EIT-team/NeuroADC/README.md

# NeuroADC
Open Source data acquisition system for biopotential recording and Fast Neural EIT, originally developed by Dr. Enrico Ravagli in 2026.
Contributions are welcome under GPL-3.0 license.
