EIT-team/NeuroADC/Schematics/README.md

# Schematics
- This subfolder contains design files for the three Printed Circuit Boards which make up the NeuroADC device. Board names are based on their physical location when assembled (top/mid/bottom)
- Boards have been designed using Cad software EAGLE. With EAGLE now being decommissioned in June 2026, board files can be opened and edited in Autodesk Fusion.
