EIT-team/NeuroADC/Data_acquisition_scripts/README.md

# Data acquisition scripts
These are example scripts for collecting data from the __NeuroADC__ device using Python and converting raw data to Matlab format.
- Script "**readout.py**" connects to the device and records data. Duration of recording and output file name can be edited in the script. Pay attention to using the serial number of your Mimas FPGA board for opening the connection.
- Script "**data_conversion.m**" reads the raw binary data file generated by the previous scripts and converts its to 32-channel format plus 8 separate trigger signals. Output is stored in a .mat file.

The scripts below are not needed for normal device operation.

- Script "**compute_CRC_lookup.m**" generates a lookup table used by data_conversion.m for CRC verification. It does not need to be run if its output "crctable.mat" is already present in the same folder.
- Script "**clean_chip.py**" resets the USB chip embedded in the FPGA board to its standard operating mode. It is useful if the readout script gets stuck for any reason (such as operating the device with the powerbank off or without pressing the start button). Run this script and then run readout.py again normally.
