EIT-team/NeuroADC/Schematics/EIT_Recorder_Mid/EIT_Recorder.brd

## EAGLE design Schematics/EIT_Recorder_Mid/EIT_Recorder.brd (2026-06-01)

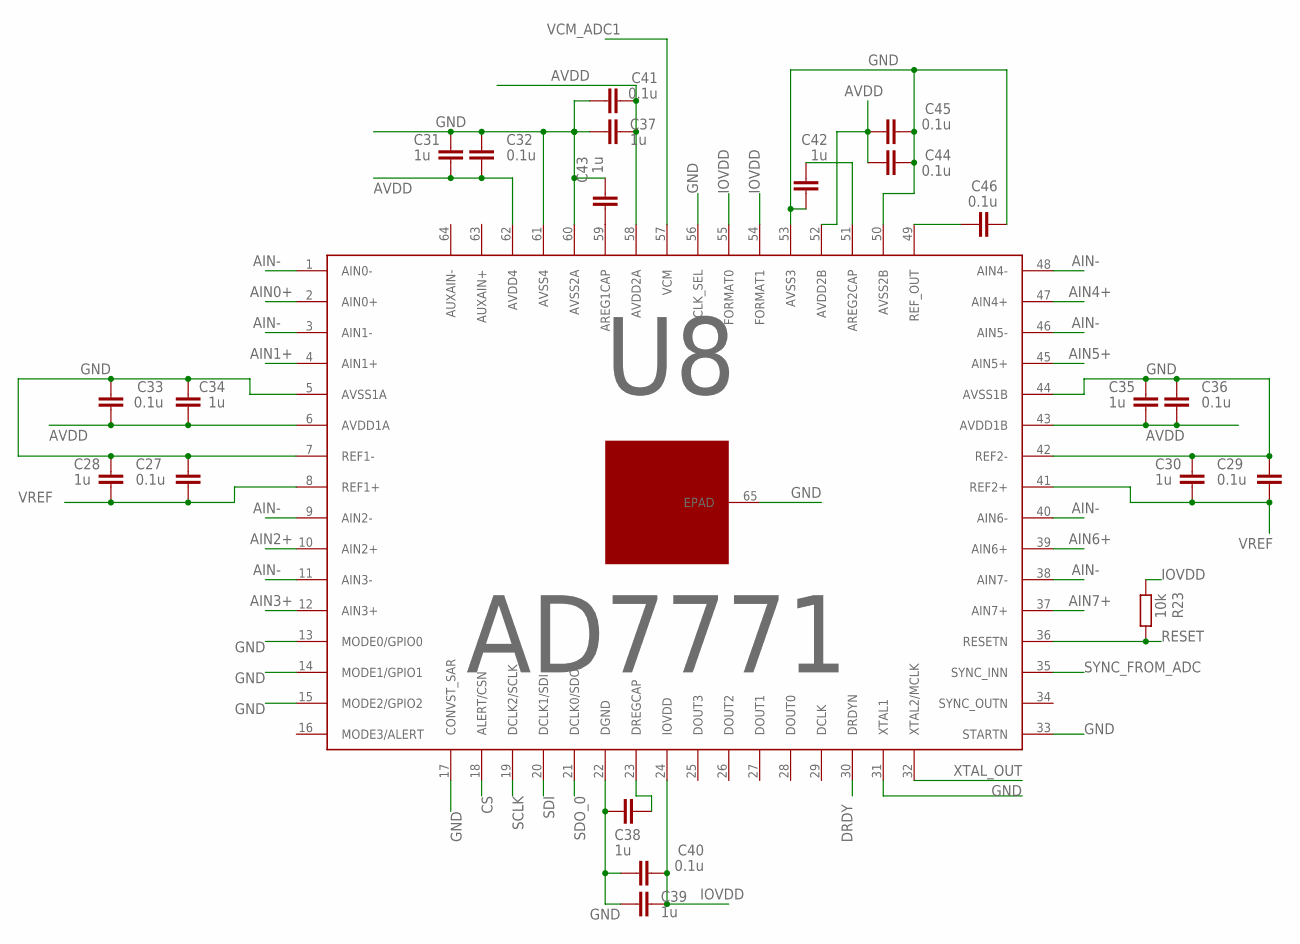
[picture p1: schematic EIT_Recorder.sch, sheet 1, ADC_1]

Parts:
C27, C29, C32, C33, C36, C40, C41, C44, C45, C46: 0.1u; C0402
C28, C30, C31, C34, C35, C37, C38, C39, C42, C43: 1u; C0402
R23: 10k; R0603
U8: AD7771; LFCSP64_CUSTOM

Connections:
AIN0+: U8.2 (AIN0+); also elsewhere on the board
AIN1+: U8.4 (AIN1+); also elsewhere on the board
AIN2+: U8.10 (AIN2+); also elsewhere on the board
AIN3+: U8.12 (AIN3+); also elsewhere on the board
AIN4+: U8.47 (AIN4+); also elsewhere on the board
AIN5+: U8.45 (AIN5+); also elsewhere on the board
AIN6+: U8.39 (AIN6+); also elsewhere on the board
AIN7+: U8.37 (AIN7+); also elsewhere on the board
AIN-: U8.1 (AIN0-), U8.3 (AIN1-), U8.9 (AIN2-), U8.11 (AIN3-), U8.38 (AIN7-), U8.40 (AIN6-), U8.46 (AIN5-), U8.48 (AIN4-); also elsewhere on the board
AVDD: C31.1, C32.1, C33.1, C34.1, C35.1, C36.1, C37.1, C41.1, C44.2, C45.2, U8.6 (AVDD1A), U8.43 (AVDD1B), U8.52 (AVDD2B), U8.58 (AVDD2A), U8.62 (AVDD4); also elsewhere on the board
CS: U8.18 (ALERT/CSN); also elsewhere on the board
DRDY: U8.30 (DRDYN); also elsewhere on the board
GND: C27.2, C28.2, C29.2, C30.2, C31.2, C32.2, C33.2, C34.2, C35.2, C36.2, C37.2, C38.1, C39.2, C40.2, C41.2, C42.2, C43.1, C44.1, C45.1, C46.1, U8.5 (AVSS1A), U8.7 (REF1-), U8.13 (MODE0/GPIO0), U8.14 (MODE1/GPIO1), U8.15 (MODE2/GPIO2), U8.17 (CONVST_SAR), U8.22 (DGND), U8.31 (XTAL1), U8.33 (STARTN), U8.42 (REF2-), U8.44 (AVSS1B), U8.50 (AVSS2B), U8.53 (AVSS3), U8.56 (CLK_SEL), U8.60 (AVSS2A), U8.61 (AVSS4), U8.65 (EPAD); also elsewhere on the board
IOVDD: C39.1, C40.1, R23.2, U8.24 (IOVDD), U8.54 (FORMAT1), U8.55 (FORMAT0); also elsewhere on the board
unnamed: C43.2, U8.59 (AREG1CAP)
unnamed: C38.2, U8.23 (DREGCAP)
unnamed: C46.2, U8.49 (REF_OUT)
unnamed: C42.1, U8.51 (AREG2CAP)
RESET: R23.1, U8.36 (RESETN); also elsewhere on the board
SCLK: U8.19 (DCLK2/SCLK); also elsewhere on the board
SDI: U8.20 (DCLK1/SDI); also elsewhere on the board
SDO_0: U8.21 (DCLK0/SDO); also elsewhere on the board
SYNC_FROM_ADC: U8.35 (SYNC_INN); also elsewhere on the board
VCM_ADC1: U8.57 (VCM); also elsewhere on the board
VREF: C27.1, C28.1, C29.1, C30.1, U8.8 (REF1+), U8.41 (REF2+); also elsewhere on the board
XTAL_OUT: U8.32 (XTAL2/MCLK); also elsewhere on the board

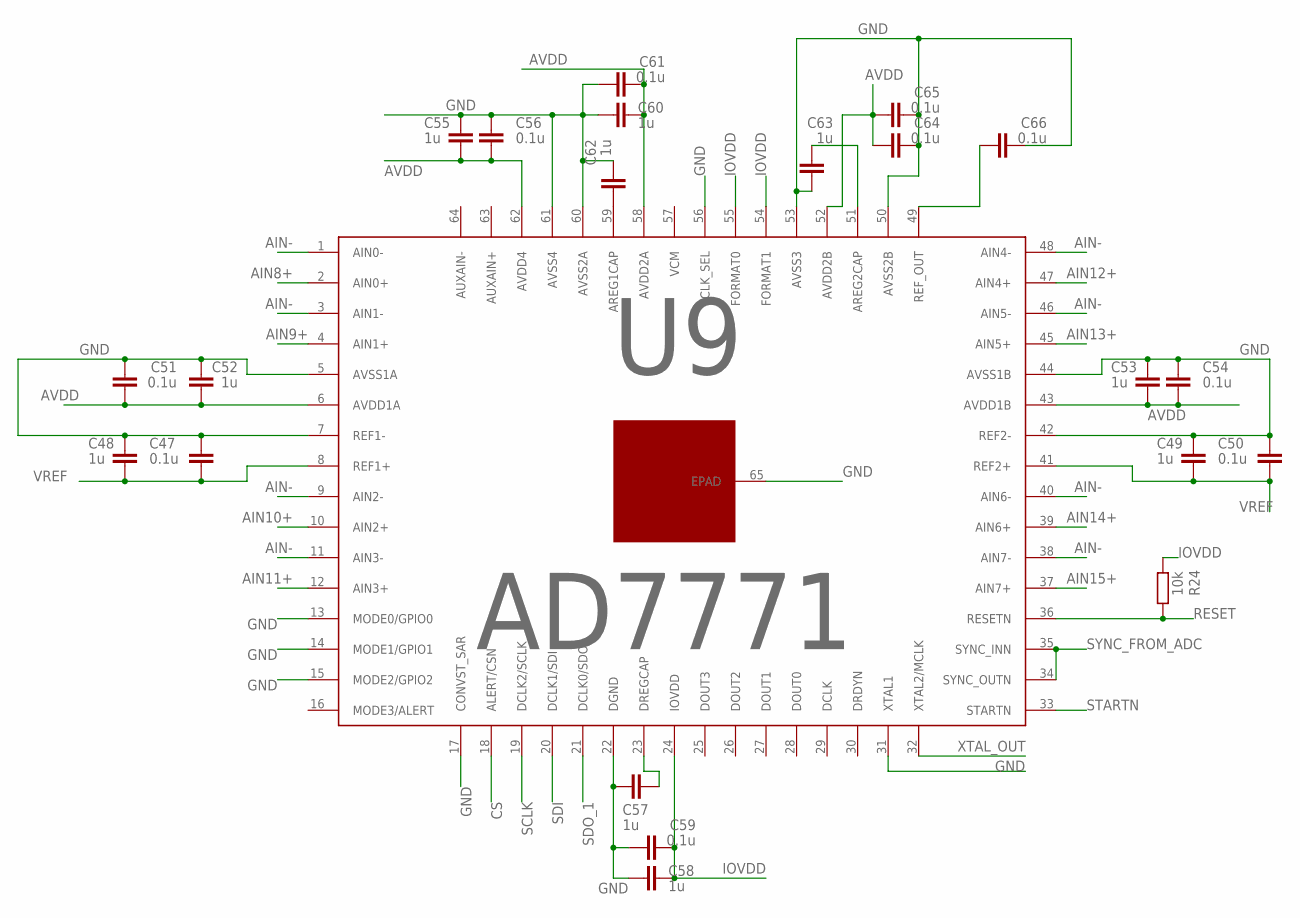
[picture p2: schematic EIT_Recorder.sch, sheet 2, ADC_2]

Parts:
C47, C50, C51, C54, C56, C59, C61, C64, C65, C66: 0.1u; C0402
C48, C49, C52, C53, C55, C57, C58, C60, C62, C63: 1u; C0402
R24: 10k; R0603
U9: AD7771; LFCSP64_CUSTOM

Connections:
AIN8+: U9.2 (AIN0+); also elsewhere on the board
AIN9+: U9.4 (AIN1+); also elsewhere on the board
AIN10+: U9.10 (AIN2+); also elsewhere on the board
AIN11+: U9.12 (AIN3+); also elsewhere on the board
AIN12+: U9.47 (AIN4+); also elsewhere on the board
AIN13+: U9.45 (AIN5+); also elsewhere on the board
AIN14+: U9.39 (AIN6+); also elsewhere on the board
AIN15+: U9.37 (AIN7+); also elsewhere on the board
AIN-: U9.1 (AIN0-), U9.3 (AIN1-), U9.9 (AIN2-), U9.11 (AIN3-), U9.38 (AIN7-), U9.40 (AIN6-), U9.46 (AIN5-), U9.48 (AIN4-); also elsewhere on the board
AVDD: C51.1, C52.1, C53.1, C54.1, C55.1, C56.1, C60.1, C61.1, C64.2, C65.2, U9.6 (AVDD1A), U9.43 (AVDD1B), U9.52 (AVDD2B), U9.58 (AVDD2A), U9.62 (AVDD4); also elsewhere on the board
CS: U9.18 (ALERT/CSN); also elsewhere on the board
GND: C47.2, C48.2, C49.2, C50.2, C51.2, C52.2, C53.2, C54.2, C55.2, C56.2, C57.1, C58.2, C59.2, C60.2, C61.2, C62.1, C63.2, C64.1, C65.1, C66.1, U9.5 (AVSS1A), U9.7 (REF1-), U9.13 (MODE0/GPIO0), U9.14 (MODE1/GPIO1), U9.15 (MODE2/GPIO2), U9.17 (CONVST_SAR), U9.22 (DGND), U9.31 (XTAL1), U9.42 (REF2-), U9.44 (AVSS1B), U9.50 (AVSS2B), U9.53 (AVSS3), U9.56 (CLK_SEL), U9.60 (AVSS2A), U9.61 (AVSS4), U9.65 (EPAD); also elsewhere on the board
IOVDD: C58.1, C59.1, R24.2, U9.24 (IOVDD), U9.54 (FORMAT1), U9.55 (FORMAT0); also elsewhere on the board
unnamed: C57.2, U9.23 (DREGCAP)
unnamed: C62.2, U9.59 (AREG1CAP)
unnamed: C63.1, U9.51 (AREG2CAP)
unnamed: C66.2, U9.49 (REF_OUT)
RESET: R24.1, U9.36 (RESETN); also elsewhere on the board
SCLK: U9.19 (DCLK2/SCLK); also elsewhere on the board
SDI: U9.20 (DCLK1/SDI); also elsewhere on the board
SDO_1: U9.21 (DCLK0/SDO); also elsewhere on the board
STARTN: U9.33 (STARTN); also elsewhere on the board
SYNC_FROM_ADC: U9.34 (SYNC_OUTN), U9.35 (SYNC_INN); also elsewhere on the board
VREF: C47.1, C48.1, C49.1, C50.1, U9.8 (REF1+), U9.41 (REF2+); also elsewhere on the board
XTAL_OUT: U9.32 (XTAL2/MCLK); also elsewhere on the board

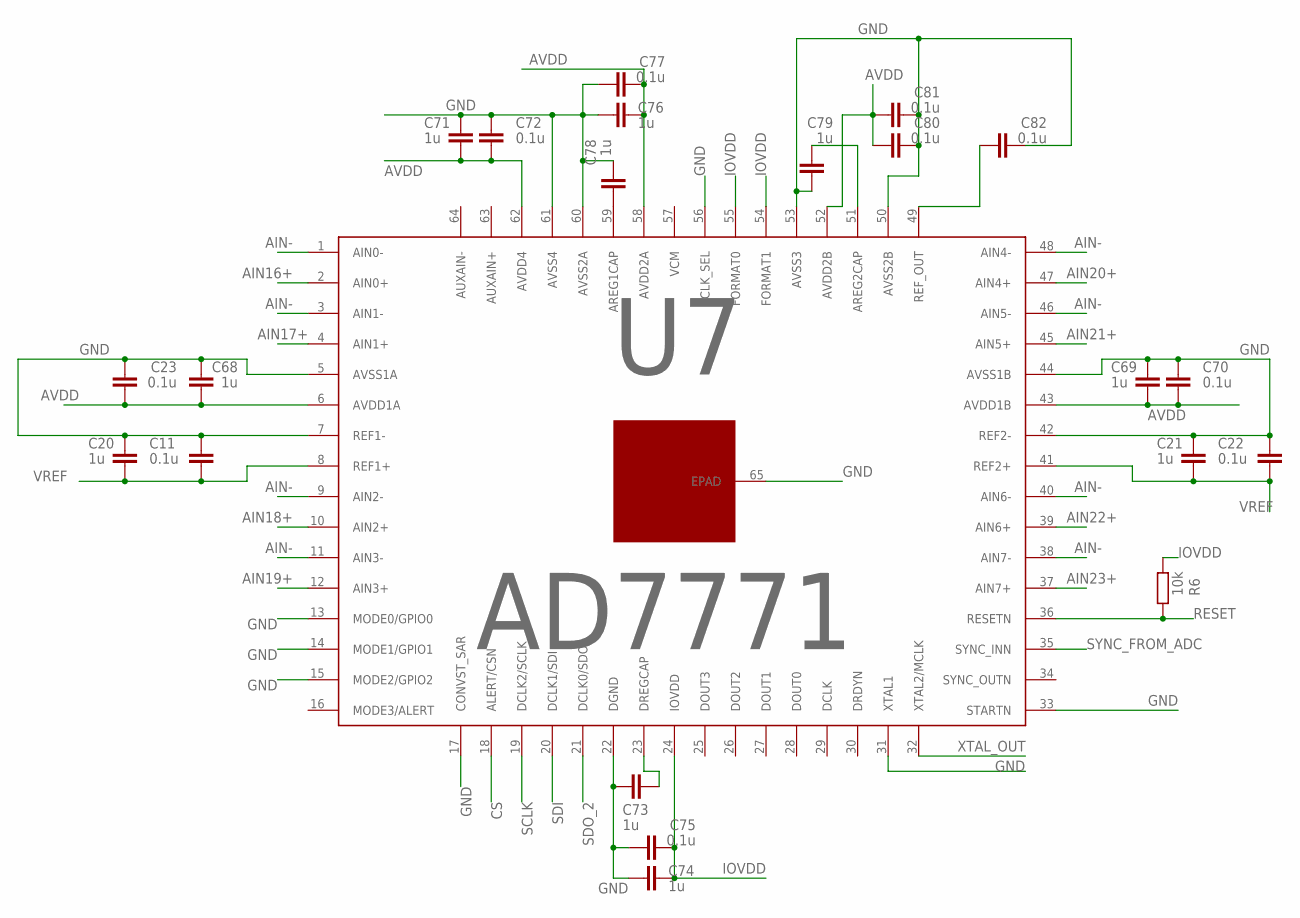
[picture p3: schematic EIT_Recorder.sch, sheet 3, ADC_3]

Parts:
C11, C22, C23, C70, C72, C75, C77, C80, C81, C82: 0.1u; C0402
C20, C21, C68, C69, C71, C73, C74, C76, C78, C79: 1u; C0402
R6: 10k; R0603
U7: AD7771; LFCSP64_CUSTOM

Connections:
AIN16+: U7.2 (AIN0+); also elsewhere on the board
AIN17+: U7.4 (AIN1+); also elsewhere on the board
AIN18+: U7.10 (AIN2+); also elsewhere on the board
AIN19+: U7.12 (AIN3+); also elsewhere on the board
AIN20+: U7.47 (AIN4+); also elsewhere on the board
AIN21+: U7.45 (AIN5+); also elsewhere on the board
AIN22+: U7.39 (AIN6+); also elsewhere on the board
AIN23+: U7.37 (AIN7+); also elsewhere on the board
AIN-: U7.1 (AIN0-), U7.3 (AIN1-), U7.9 (AIN2-), U7.11 (AIN3-), U7.38 (AIN7-), U7.40 (AIN6-), U7.46 (AIN5-), U7.48 (AIN4-); also elsewhere on the board
AVDD: C23.1, C68.1, C69.1, C70.1, C71.1, C72.1, C76.1, C77.1, C80.2, C81.2, U7.6 (AVDD1A), U7.43 (AVDD1B), U7.52 (AVDD2B), U7.58 (AVDD2A), U7.62 (AVDD4); also elsewhere on the board
CS: U7.18 (ALERT/CSN); also elsewhere on the board
GND: C11.2, C20.2, C21.2, C22.2, C23.2, C68.2, C69.2, C70.2, C71.2, C72.2, C73.1, C74.2, C75.2, C76.2, C77.2, C78.1, C79.2, C80.1, C81.1, C82.1, U7.5 (AVSS1A), U7.7 (REF1-), U7.13 (MODE0/GPIO0), U7.14 (MODE1/GPIO1), U7.15 (MODE2/GPIO2), U7.17 (CONVST_SAR), U7.22 (DGND), U7.31 (XTAL1), U7.33 (STARTN), U7.42 (REF2-), U7.44 (AVSS1B), U7.50 (AVSS2B), U7.53 (AVSS3), U7.56 (CLK_SEL), U7.60 (AVSS2A), U7.61 (AVSS4), U7.65 (EPAD); also elsewhere on the board
IOVDD: C74.1, C75.1, R6.2, U7.24 (IOVDD), U7.54 (FORMAT1), U7.55 (FORMAT0); also elsewhere on the board
unnamed: C73.2, U7.23 (DREGCAP)
unnamed: C78.2, U7.59 (AREG1CAP)
unnamed: C79.1, U7.51 (AREG2CAP)
unnamed: C82.2, U7.49 (REF_OUT)
RESET: R6.1, U7.36 (RESETN); also elsewhere on the board
SCLK: U7.19 (DCLK2/SCLK); also elsewhere on the board
SDI: U7.20 (DCLK1/SDI); also elsewhere on the board
SDO_2: U7.21 (DCLK0/SDO); also elsewhere on the board
SYNC_FROM_ADC: U7.35 (SYNC_INN); also elsewhere on the board
VREF: C11.1, C20.1, C21.1, C22.1, U7.8 (REF1+), U7.41 (REF2+); also elsewhere on the board
XTAL_OUT: U7.32 (XTAL2/MCLK); also elsewhere on the board

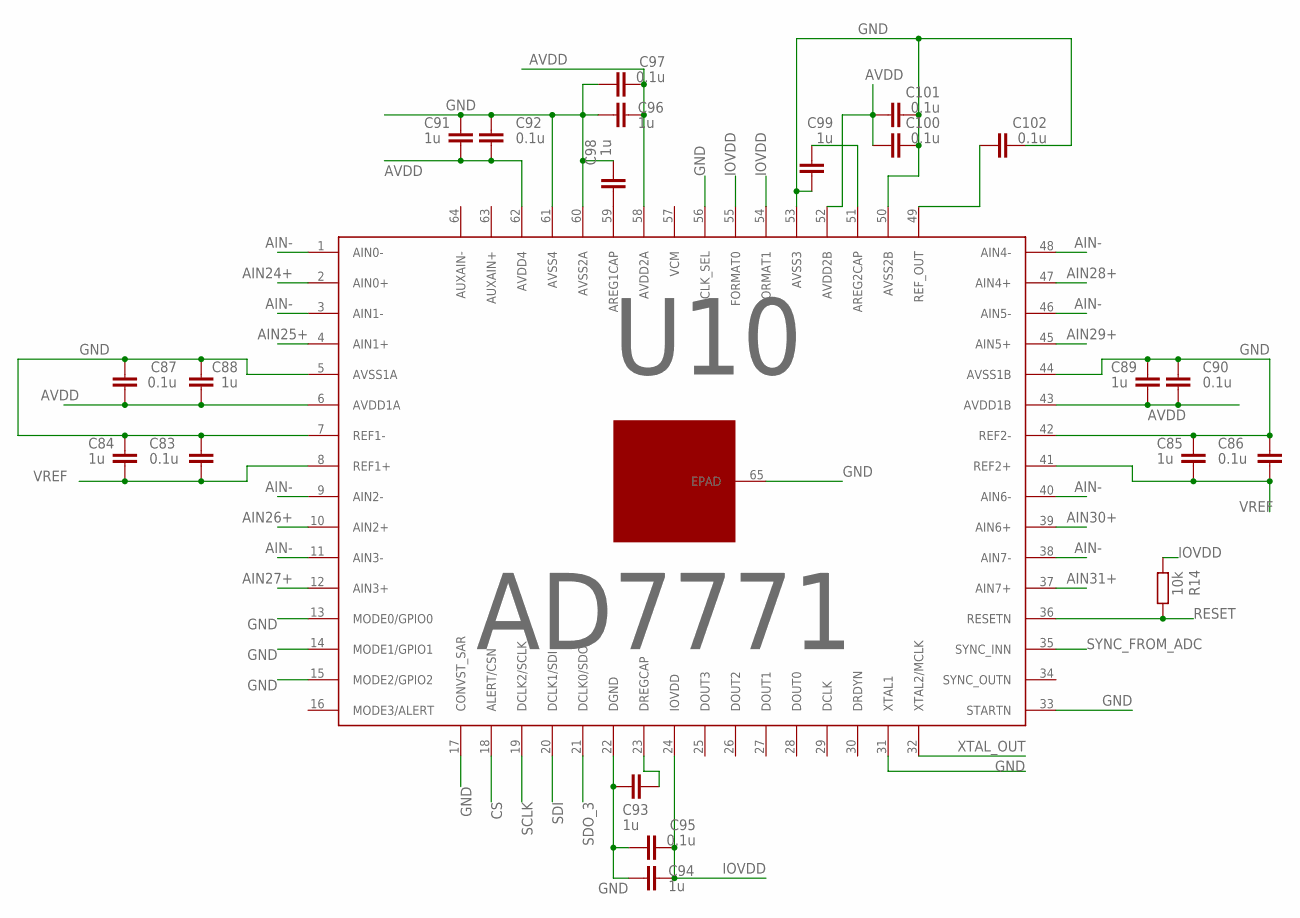
[picture p4: schematic EIT_Recorder.sch, sheet 4, ADC_4]

Parts:
C83, C86, C87, C90, C92, C95, C97, C100, C101, C102: 0.1u; C0402
C84, C85, C88, C89, C91, C93, C94, C96, C98, C99: 1u; C0402
R14: 10k; R0603
U10: AD7771; LFCSP64_CUSTOM

Connections:
AIN24+: U10.2 (AIN0+); also elsewhere on the board
AIN25+: U10.4 (AIN1+); also elsewhere on the board
AIN26+: U10.10 (AIN2+); also elsewhere on the board
AIN27+: U10.12 (AIN3+); also elsewhere on the board
AIN28+: U10.47 (AIN4+); also elsewhere on the board
AIN29+: U10.45 (AIN5+); also elsewhere on the board
AIN30+: U10.39 (AIN6+); also elsewhere on the board
AIN31+: U10.37 (AIN7+); also elsewhere on the board
AIN-: U10.1 (AIN0-), U10.3 (AIN1-), U10.9 (AIN2-), U10.11 (AIN3-), U10.38 (AIN7-), U10.40 (AIN6-), U10.46 (AIN5-), U10.48 (AIN4-); also elsewhere on the board
AVDD: C87.1, C88.1, C89.1, C90.1, C91.1, C92.1, C96.1, C97.1, C100.2, C101.2, U10.6 (AVDD1A), U10.43 (AVDD1B), U10.52 (AVDD2B), U10.58 (AVDD2A), U10.62 (AVDD4); also elsewhere on the board
CS: U10.18 (ALERT/CSN); also elsewhere on the board
GND: C83.2, C84.2, C85.2, C86.2, C87.2, C88.2, C89.2, C90.2, C91.2, C92.2, C93.1, C94.2, C95.2, C96.2, C97.2, C98.1, C99.2, C100.1, C101.1, C102.1, U10.5 (AVSS1A), U10.7 (REF1-), U10.13 (MODE0/GPIO0), U10.14 (MODE1/GPIO1), U10.15 (MODE2/GPIO2), U10.17 (CONVST_SAR), U10.22 (DGND), U10.31 (XTAL1), U10.33 (STARTN), U10.42 (REF2-), U10.44 (AVSS1B), U10.50 (AVSS2B), U10.53 (AVSS3), U10.56 (CLK_SEL), U10.60 (AVSS2A), U10.61 (AVSS4), U10.65 (EPAD); also elsewhere on the board
IOVDD: C94.1, C95.1, R14.2, U10.24 (IOVDD), U10.54 (FORMAT1), U10.55 (FORMAT0); also elsewhere on the board
unnamed: C93.2, U10.23 (DREGCAP)
unnamed: C98.2, U10.59 (AREG1CAP)
unnamed: C99.1, U10.51 (AREG2CAP)
unnamed: C102.2, U10.49 (REF_OUT)
RESET: R14.1, U10.36 (RESETN); also elsewhere on the board
SCLK: U10.19 (DCLK2/SCLK); also elsewhere on the board
SDI: U10.20 (DCLK1/SDI); also elsewhere on the board
SDO_3: U10.21 (DCLK0/SDO); also elsewhere on the board
SYNC_FROM_ADC: U10.35 (SYNC_INN); also elsewhere on the board
VREF: C83.1, C84.1, C85.1, C86.1, U10.8 (REF1+), U10.41 (REF2+); also elsewhere on the board
XTAL_OUT: U10.32 (XTAL2/MCLK); also elsewhere on the board

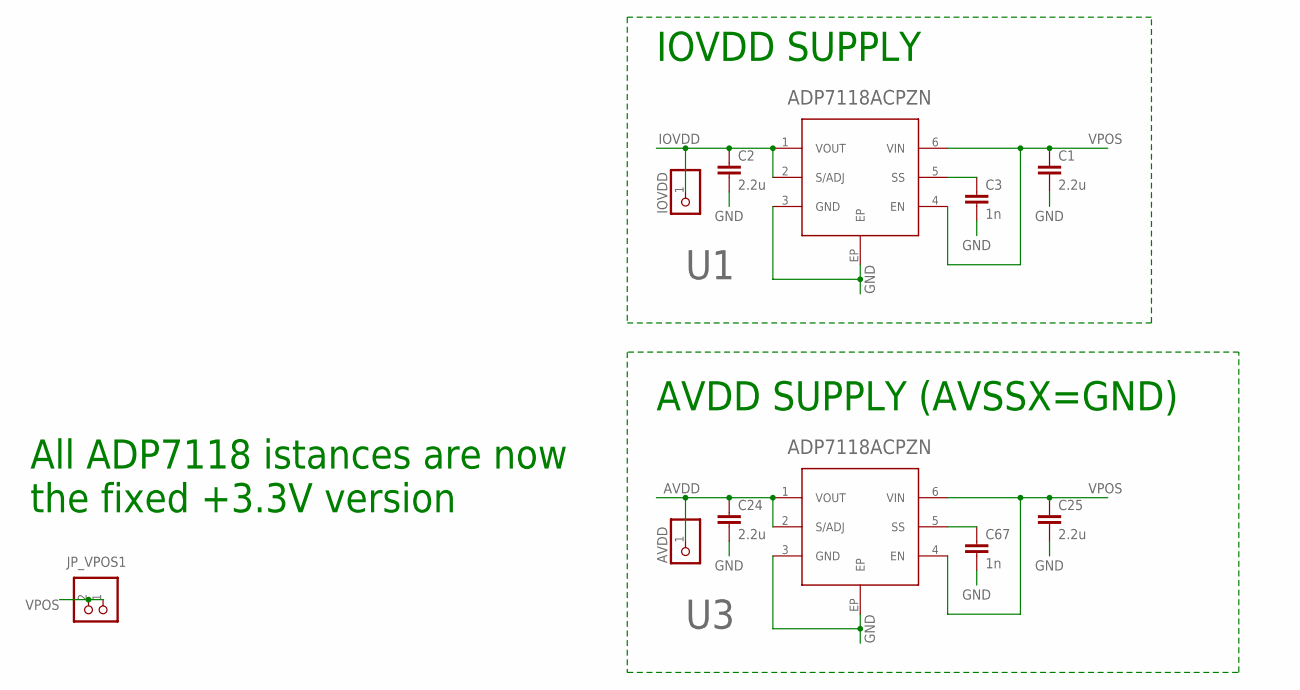
[picture p5: schematic EIT_Recorder.sch, sheet 5, POWER_MANAGEMENT_1]

Parts:
AVDD: PINHD-1X1; 1X01
C1, C2, C24, C25: 2.2u; C0603
C3, C67: 1n; C0402
IOVDD: PINHD-1X1; 1X01
JP_VPOS1: PINHD-1X2; 1X02
U1, U3: ADP7118ACPZN; LFCSP6_CUSTOM

Connections:
AVDD: AVDD.1, C24.1, U3.1 (VOUT), U3.2 (S/ADJ); also elsewhere on the board
GND: C1.2, C2.2, C3.2, C24.2, C25.2, C67.2, U1.3 (GND), U1.EP, U3.3 (GND), U3.EP; also elsewhere on the board
IOVDD: C2.1, IOVDD.1, U1.1 (VOUT), U1.2 (S/ADJ); also elsewhere on the board
unnamed: C3.1, U1.5 (SS)
unnamed: C67.1, U3.5 (SS)
VPOS: C1.1, C25.1, JP_VPOS1.1, JP_VPOS1.2, U1.4 (EN), U1.6 (VIN), U3.4 (EN), U3.6 (VIN); also elsewhere on the board

Notes on the sheet:
IOVDD SUPPLY
AVDD SUPPLY (AVSSX=GND)
All ADP7118 istances are now the fixed +3.3V version

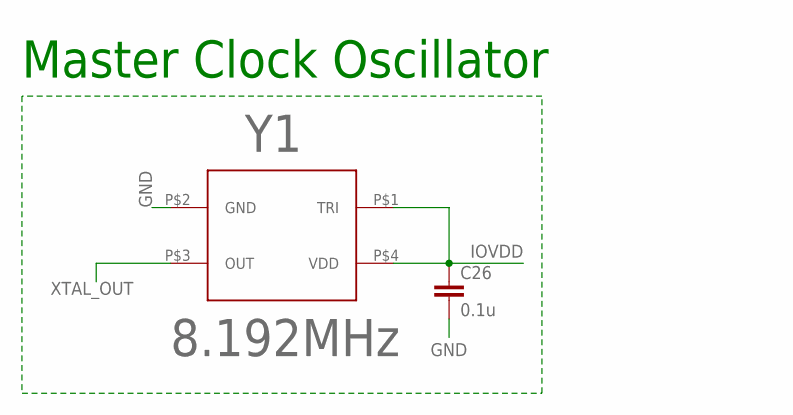
[picture p6: schematic EIT_Recorder.sch, sheet 6, POWER_MANAGEMENT_2]

Parts:
C26: 0.1u; C0402
Y1: 8.192MHz; ECS-2520MVLC

Connections:
GND: C26.2, Y1.P$2 (GND); also elsewhere on the board
IOVDD: C26.1, Y1.P$1 (TRI), Y1.P$4 (VDD); also elsewhere on the board
XTAL_OUT: Y1.P$3 (OUT); also elsewhere on the board

Notes on the sheet:
Master Clock Oscillator

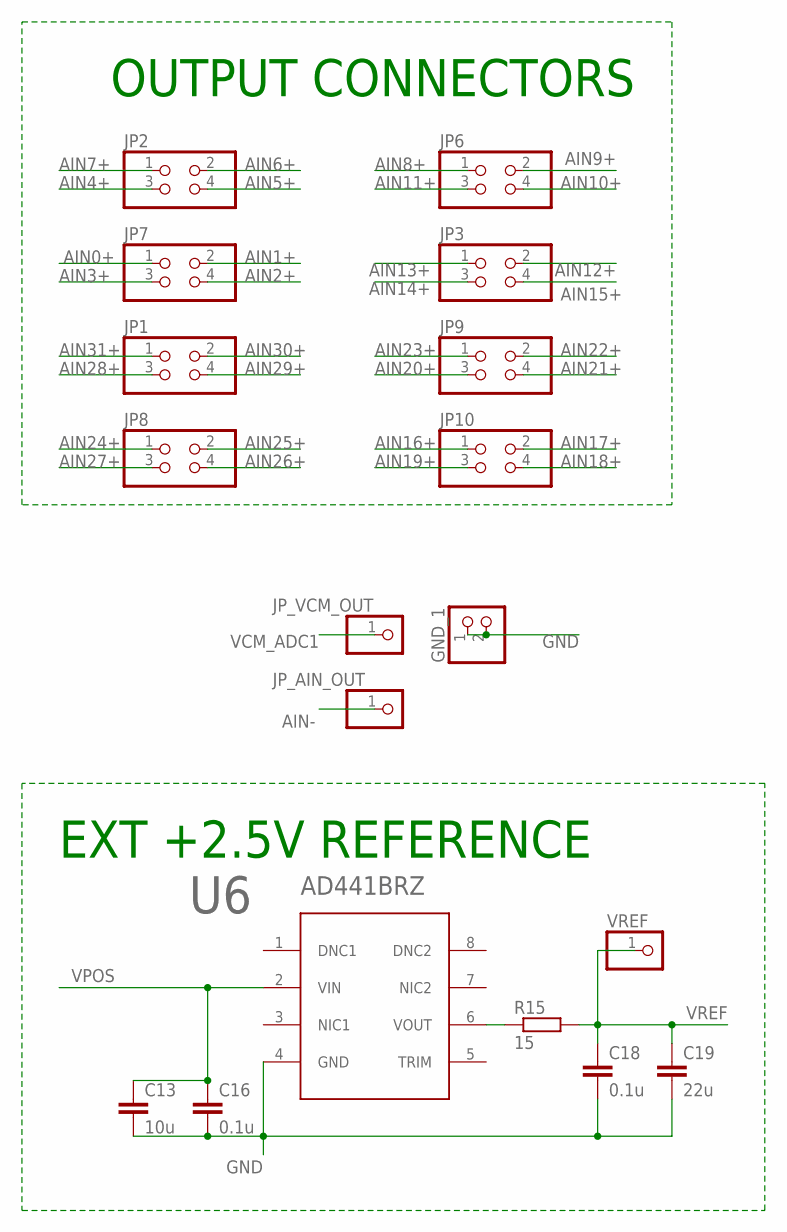
[picture p7: schematic EIT_Recorder.sch, sheet 7, BUFFERS_AND_VREF]

Parts:
C13: 10u; C0805
C16, C18: 0.1u; C0402
C19: 22u; C0805
GND_1: PINHD-1X2; 1X02
JP1, JP2, JP3, JP6, JP7, JP8, JP9, JP10: PINHD-2X2; 2X02
JP_AIN_OUT: PINHD-1X1; 1X01
JP_VCM_OUT: PINHD-1X1; 1X01
R15: 15; R0603
U6: AD441BRZ; SOIC8N_CUSTOM
VREF: PINHD-1X1; 1X01

Connections:
AIN0+: JP7.1; also elsewhere on the board
AIN1+: JP7.2; also elsewhere on the board
AIN2+: JP7.4; also elsewhere on the board
AIN3+: JP7.3; also elsewhere on the board
AIN4+: JP2.3; also elsewhere on the board
AIN5+: JP2.4; also elsewhere on the board
AIN6+: JP2.2; also elsewhere on the board
AIN7+: JP2.1; also elsewhere on the board
AIN8+: JP6.1; also elsewhere on the board
AIN9+: JP6.2; also elsewhere on the board
AIN10+: JP6.4; also elsewhere on the board
AIN11+: JP6.3; also elsewhere on the board
AIN12+: JP3.2; also elsewhere on the board
AIN13+: JP3.1; also elsewhere on the board
AIN14+: JP3.3; also elsewhere on the board
AIN15+: JP3.4; also elsewhere on the board
AIN16+: JP10.1; also elsewhere on the board
AIN17+: JP10.2; also elsewhere on the board
AIN18+: JP10.4; also elsewhere on the board
AIN19+: JP10.3; also elsewhere on the board
AIN20+: JP9.3; also elsewhere on the board
AIN21+: JP9.4; also elsewhere on the board
AIN22+: JP9.2; also elsewhere on the board
AIN23+: JP9.1; also elsewhere on the board
AIN24+: JP8.1; also elsewhere on the board
AIN25+: JP8.2; also elsewhere on the board
AIN26+: JP8.4; also elsewhere on the board
AIN27+: JP8.3; also elsewhere on the board
AIN28+: JP1.3; also elsewhere on the board
AIN29+: JP1.4; also elsewhere on the board
AIN30+: JP1.2; also elsewhere on the board
AIN31+: JP1.1; also elsewhere on the board
AIN-: JP_AIN_OUT.1; also elsewhere on the board
GND: C13.2, C16.2, C18.2, C19.2, GND_1.1, GND_1.2, U6.4 (GND); also elsewhere on the board
unnamed: R15.1, U6.6 (VOUT)
VCM_ADC1: JP_VCM_OUT.1; also elsewhere on the board
VPOS: C13.1, C16.1, U6.2 (VIN); also elsewhere on the board
VREF: C18.1, C19.1, R15.2, VREF.1; also elsewhere on the board

Notes on the sheet:
EXT +2.5V REFERENCE
OUTPUT CONNECTORS

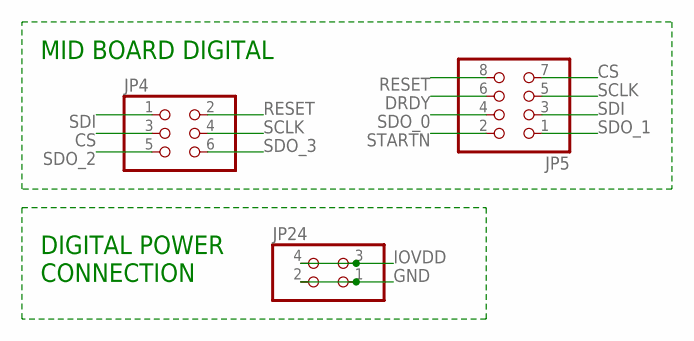
[picture p8: schematic EIT_Recorder.sch, sheet 8, DIGITAL]

Parts:
JP4: PINHD-2X3; 2X03
JP5: PINHD-2X4; 2X04
JP24: PINHD-2X2; 2X02

Connections:
CS: JP4.3, JP5.7; also elsewhere on the board
DRDY: JP5.6; also elsewhere on the board
GND: JP24.1, JP24.2; also elsewhere on the board
IOVDD: JP24.3, JP24.4; also elsewhere on the board
RESET: JP4.2, JP5.8; also elsewhere on the board
SCLK: JP4.4, JP5.5; also elsewhere on the board
SDI: JP4.1, JP5.3; also elsewhere on the board
SDO_0: JP5.4; also elsewhere on the board
SDO_1: JP5.1; also elsewhere on the board
SDO_2: JP4.5; also elsewhere on the board
SDO_3: JP4.6; also elsewhere on the board
STARTN: JP5.2; also elsewhere on the board

Notes on the sheet:
MID BOARD DIGITAL
DIGITAL POWER CONNECTION

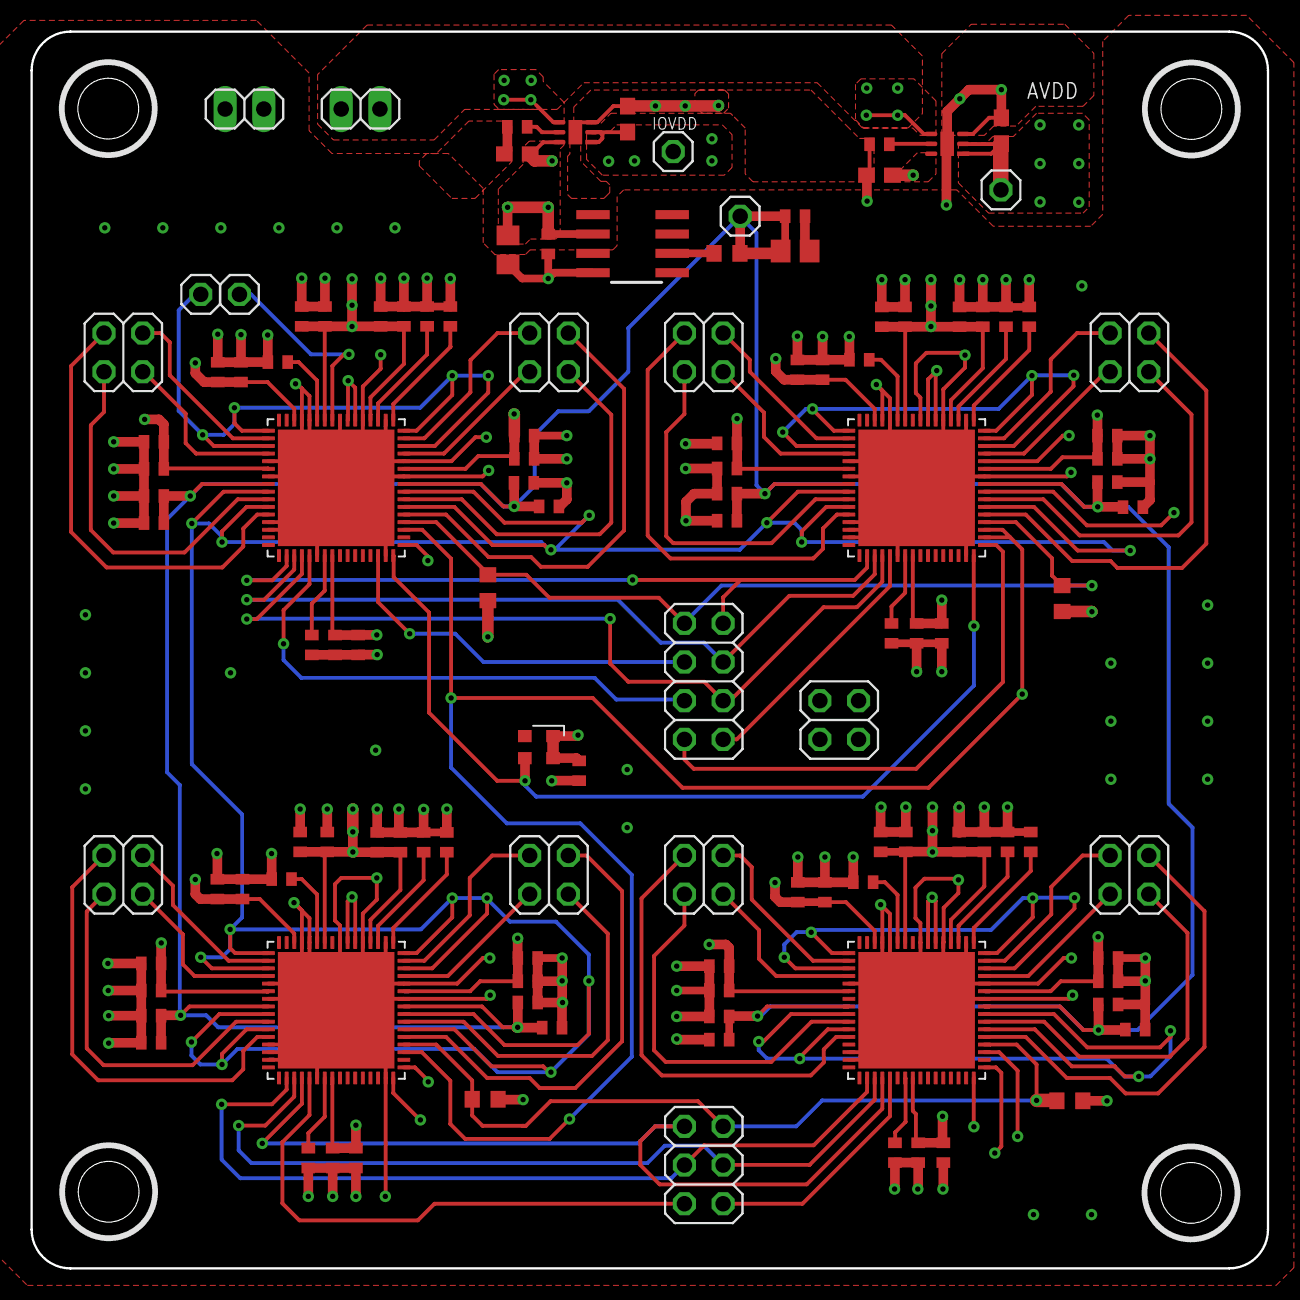
[picture p9: board Schematics/EIT_Recorder_Mid/EIT_Recorder.brd from above]

Board: 6 copper layers, 81.2 x 81.2 mm, 122 parts (0 on the bottom side), 70 nets.
