EIT-team/NeuroADC/Schematics/EIT_Recorder_Top/EIT_Recorder.brd

## EAGLE design Schematics/EIT_Recorder_Top/EIT_Recorder.brd (2026-06-01)

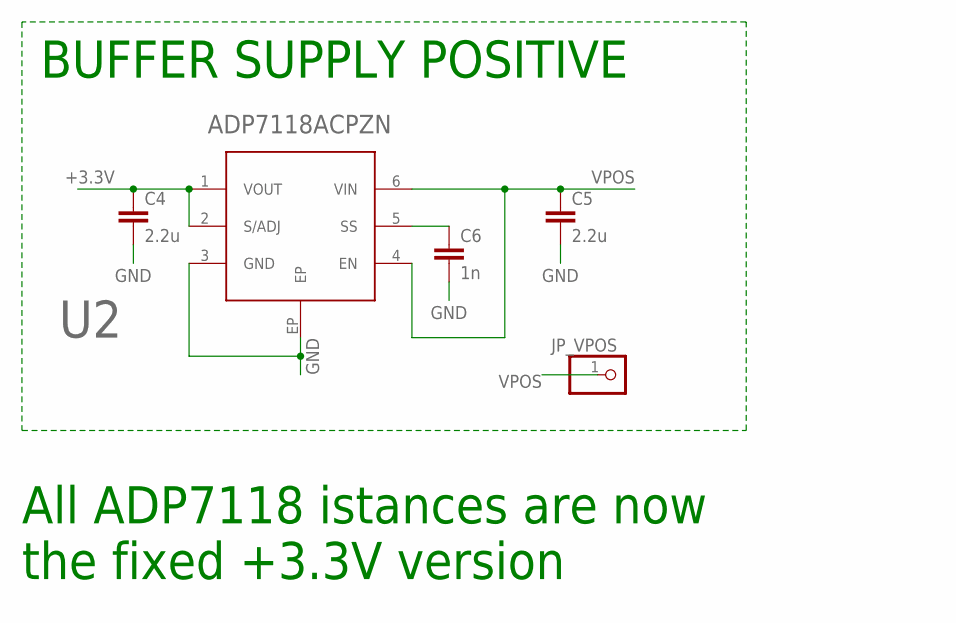
[picture p10: schematic EIT_Recorder.sch, sheet 1, POWER_MANAGEMENT_1]

Parts:
C4, C5: 2.2u; C0603
C6: 1n; C0402
JP_VPOS: PINHD-1X1; 1X01
U2: ADP7118ACPZN; LFCSP6_CUSTOM

Connections:
+3.3V: C4.1, U2.1 (VOUT), U2.2 (S/ADJ); also elsewhere on the board
GND: C4.2, C5.2, C6.2, U2.3 (GND), U2.EP; also elsewhere on the board
unnamed: C6.1, U2.5 (SS)
VPOS: C5.1, JP_VPOS.1, U2.4 (EN), U2.6 (VIN); also elsewhere on the board

Notes on the sheet:
BUFFER SUPPLY POSITIVE
All ADP7118 istances are now the fixed +3.3V version

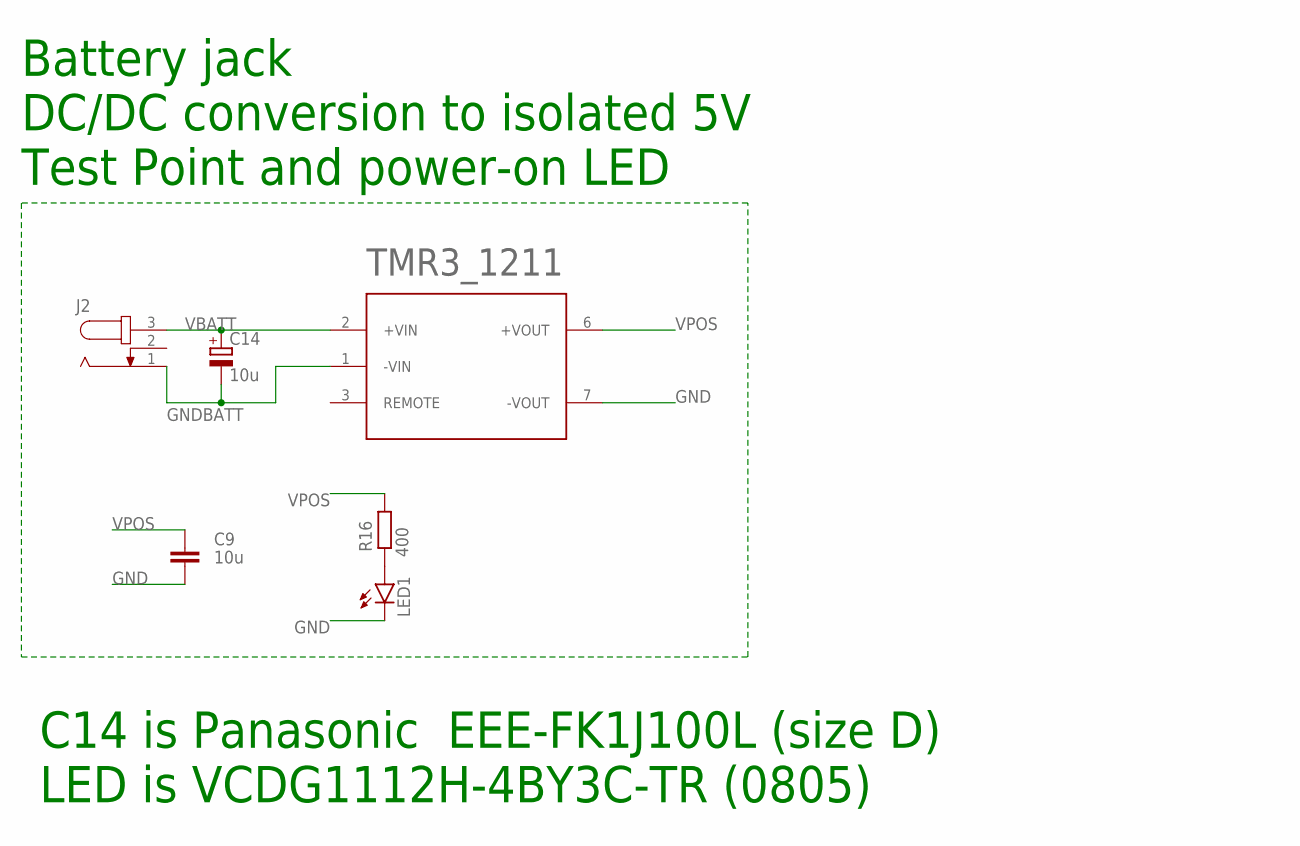
[picture p11: schematic EIT_Recorder.sch, sheet 2, POWER_MANAGEMENT_2]

Parts:
C9: 10u; C0805
C14: 10u; PANASONIC_D
J2: JACK-PLUG0; SPC4077
LED1: LEDCHIP-LED0805; CHIP-LED0805
R16: 400; R0805
TMR3_1211: TMR3_1211

Connections:
GND: C9.2, LED1.C, TMR3_1211.7 (-VOUT); also elsewhere on the board
GNDBATT: C14.-, J2.1, TMR3_1211.1 (-VIN)
unnamed: LED1.A, R16.1
VBATT: C14.+, J2.3, TMR3_1211.2 (+VIN)
VPOS: C9.1, R16.2, TMR3_1211.6 (+VOUT); also elsewhere on the board

Notes on the sheet:
C14 is Panasonic EEE-FK1J100L (size D) LED is VCDG1112H-4BY3C-TR (0805)
Battery jack DC/DC conversion to isolated 5V Test Point and power-on LED

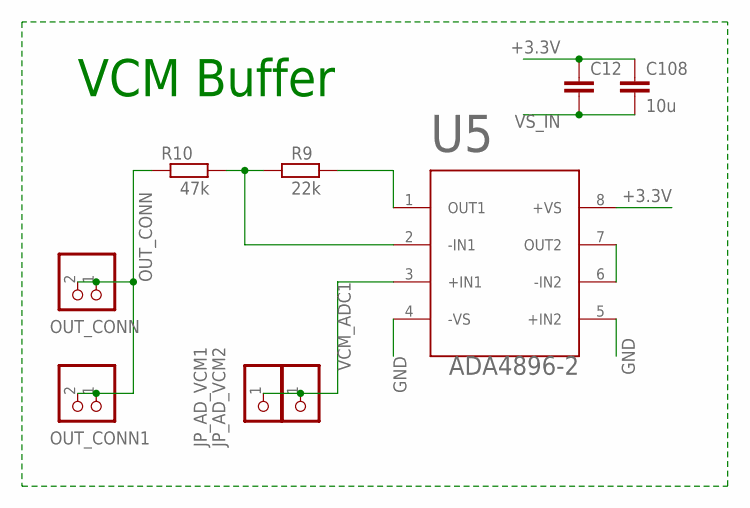
[picture p12: schematic EIT_Recorder.sch, sheet 3, BUFFERS_AND_VREF]

Parts:
C12: 0.1u; C0402
C108: 10u; C0805
JP_AD_VCM1, JP_AD_VCM2: PINHD-1X1; 1X01
OUT_CONN, OUT_CONN1: PINHD-1X2; 1X02
R9: 22k; R0603
R10: 47k; R0603
U5: ADA4896-2; MSOP8_CUSTOM

Connections:
+3.3V: C12.1, C108.1, U5.8 (+VS); also elsewhere on the board
GND: U5.4 (-VS), U5.5 (+IN2); also elsewhere on the board
unnamed: U5.6 (-IN2), U5.7 (OUT2)
unnamed: R9.2, U5.1 (OUT1)
unnamed: R9.1, R10.2, U5.2 (-IN1)
OUT_CONN: OUT_CONN.1, OUT_CONN.2, OUT_CONN1.1, OUT_CONN1.2, R10.1
VCM_ADC1: JP_AD_VCM1.1, JP_AD_VCM2.1, U5.3 (+IN1)
VS_IN: C12.2, C108.2

Notes on the sheet:
VCM Buffer

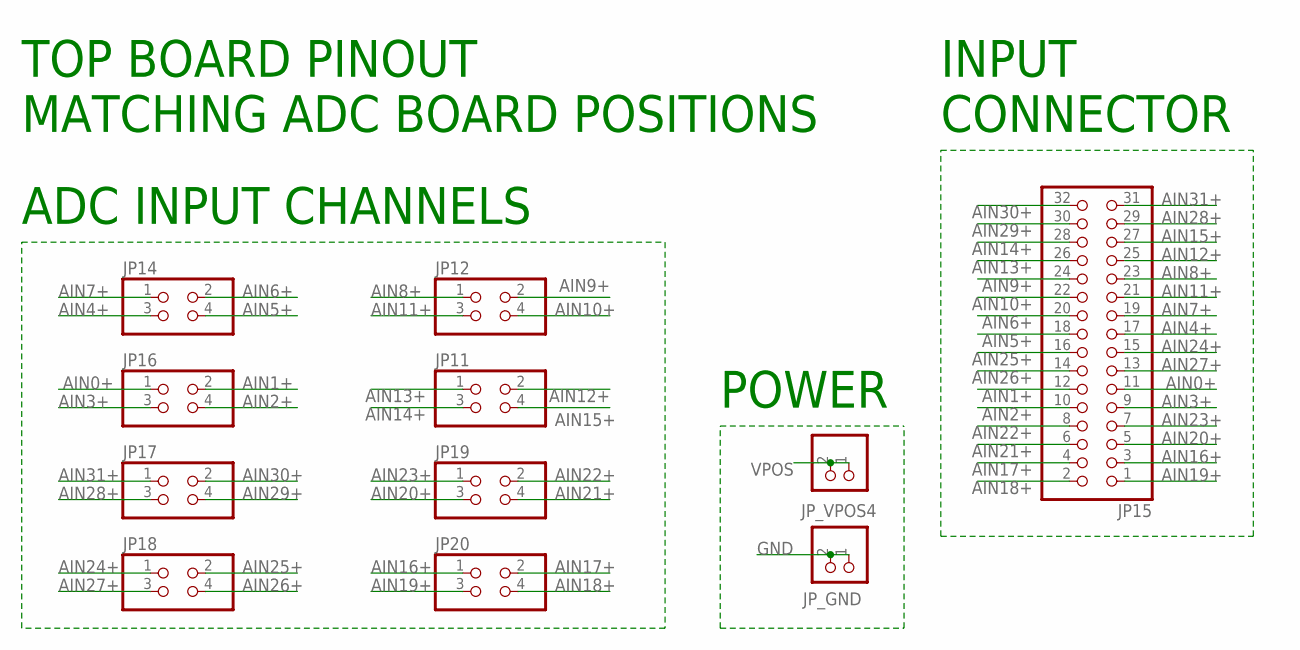
[picture p13: schematic EIT_Recorder.sch, sheet 4, TOP BOARD CONNECTOR MATCHING]

Parts:
JP11, JP12, JP14, JP16, JP17, JP18, JP19, JP20: PINHD-2X2; 2X02
JP15: PINHD-2X16; 2X16
JP_GND: PINHD-1X2; 1X02
JP_VPOS4: PINHD-1X2; 1X02

Connections:
AIN0+: JP15.11, JP16.1
AIN1+: JP15.12, JP16.2
AIN2+: JP15.10, JP16.4
AIN3+: JP15.9, JP16.3
AIN4+: JP14.3, JP15.17
AIN5+: JP14.4, JP15.18
AIN6+: JP14.2, JP15.20
AIN7+: JP14.1, JP15.19
AIN8+: JP12.1, JP15.23
AIN9+: JP12.2, JP15.24
AIN10+: JP12.4, JP15.22
AIN11+: JP12.3, JP15.21
AIN12+: JP11.2, JP15.25
AIN13+: JP11.1, JP15.26
AIN14+: JP11.3, JP15.28
AIN15+: JP11.4, JP15.27
AIN16+: JP15.3, JP20.1
AIN17+: JP15.4, JP20.2
AIN18+: JP15.2, JP20.4
AIN19+: JP15.1, JP20.3
AIN20+: JP15.5, JP19.3
AIN21+: JP15.6, JP19.4
AIN22+: JP15.8, JP19.2
AIN23+: JP15.7, JP19.1
AIN24+: JP15.15, JP18.1
AIN25+: JP15.16, JP18.2
AIN26+: JP15.14, JP18.4
AIN27+: JP15.13, JP18.3
AIN28+: JP15.29, JP17.3
AIN29+: JP15.30, JP17.4
AIN30+: JP15.32, JP17.2
AIN31+: JP15.31, JP17.1
GND: JP_GND.1, JP_GND.2; also elsewhere on the board
VPOS: JP_VPOS4.1, JP_VPOS4.2; also elsewhere on the board

Notes on the sheet:
POWER
ADC INPUT CHANNELS
TOP BOARD PINOUT MATCHING ADC BOARD POSITIONS
INPUT CONNECTOR
