EIT-team/NeuroADC/Schematics/EIT_Recorder_Top/EIT_Recorder.brd

## EAGLE design Schematics/EIT_Recorder_Top/EIT_Recorder.brd (continued)

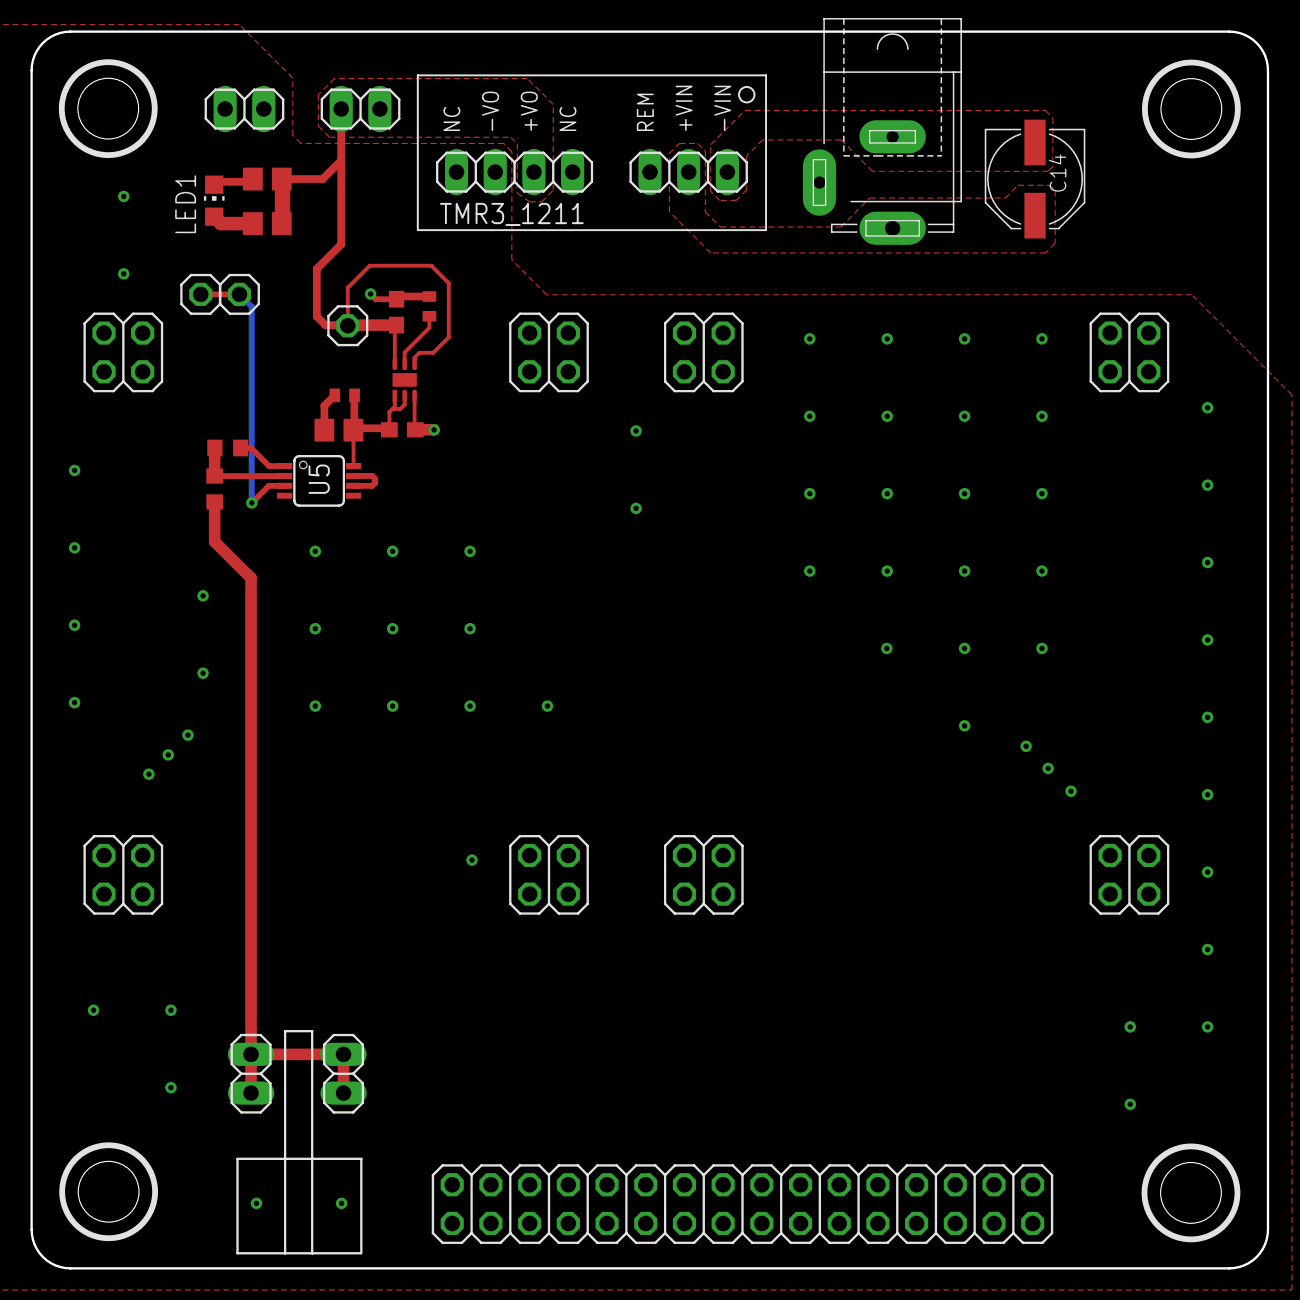
[picture p14: board Schematics/EIT_Recorder_Top/EIT_Recorder.brd from above]

Board: 4 copper layers, 81.2 x 81.2 mm, 31 parts (0 on the bottom side), 45 nets.
