EIT-team/NeuroADC/Schematics/EIT_Recorder_Bottom/EIT_Recorder.brd

## EAGLE design Schematics/EIT_Recorder_Bottom/EIT_Recorder.brd (2026-06-01)

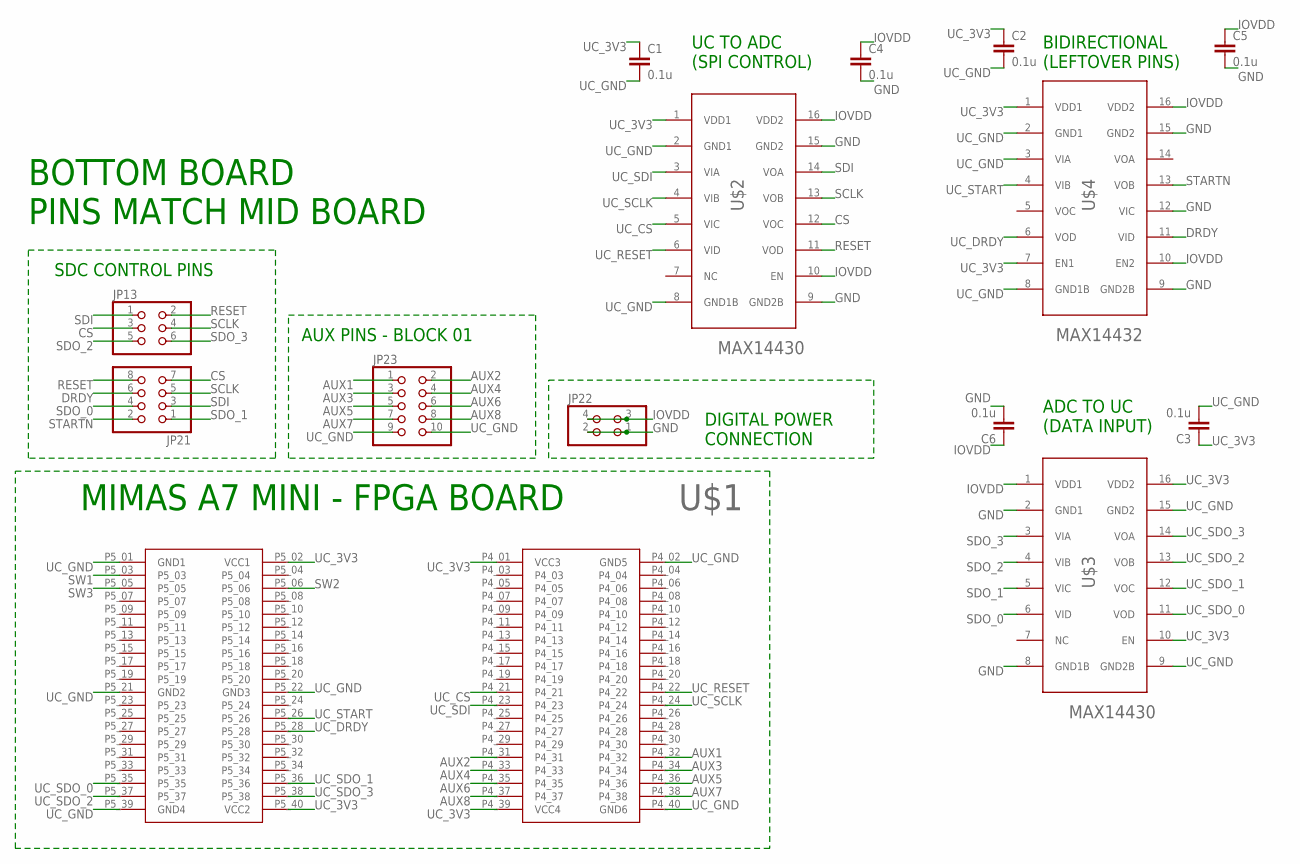
[picture p15: schematic EIT_Recorder.sch, sheet 1, DIGITAL]

Parts:
C1, C2, C3, C4, C5, C6: 0.1u; C0805
JP13: PINHD-2X3; 2X03
JP21: PINHD-2X4; 2X04
JP22: PINHD-2X2; 2X02
JP23: PINHD-2X5/90; 2X05/90
U$1: MIMAS_A7_MINI
U$2, U$3: MAX14430; SOIC16_CUSTOM
U$4: MAX14432; SOIC16_CUSTOM

Connections:
AUX1: JP23.1, U$1.P4_32
AUX2: JP23.2, U$1.P4_31
AUX3: JP23.3, U$1.P4_34
AUX4: JP23.4, U$1.P4_33
AUX5: JP23.5, U$1.P4_36
AUX6: JP23.6, U$1.P4_35
AUX7: JP23.7, U$1.P4_38
AUX8: JP23.8, U$1.P4_37
CS: JP13.3, JP21.7, U$2.12 (VOC)
DRDY: JP21.6, U$4.11 (VID)
GND: C4.2, C5.2, C6.2, JP22.1, JP22.2, U$2.9 (GND2B), U$2.15 (GND2), U$3.2 (GND1), U$3.8 (GND1B), U$4.9 (GND2B), U$4.12 (VIC), U$4.15 (GND2)
IOVDD: C4.1, C5.1, C6.1, JP22.3, JP22.4, U$2.10 (EN), U$2.16 (VDD2), U$3.1 (VDD1), U$4.10 (EN2), U$4.16 (VDD2)
RESET: JP13.2, JP21.8, U$2.11 (VOD)
SCLK: JP13.4, JP21.5, U$2.13 (VOB)
SDI: JP13.1, JP21.3, U$2.14 (VOA)
SDO_0: JP21.4, U$3.6 (VID)
SDO_1: JP21.1, U$3.5 (VIC)
SDO_2: JP13.5, U$3.4 (VIB)
SDO_3: JP13.6, U$3.3 (VIA)
STARTN: JP21.2, U$4.13 (VOB)
SW1: U$1.P5_03; also elsewhere on the board
SW2: U$1.P5_06; also elsewhere on the board
SW3: U$1.P5_05; also elsewhere on the board
UC_3V3: C1.1, C2.1, C3.1, U$1.P4_01 (VCC3), U$1.P4_39 (VCC4), U$1.P5_02 (VCC1), U$1.P5_40 (VCC2), U$2.1 (VDD1), U$3.10 (EN), U$3.16 (VDD2), U$4.1 (VDD1), U$4.7 (EN1); also elsewhere on the board
UC_CS: U$1.P4_21, U$2.5 (VIC)
UC_DRDY: U$1.P5_28, U$4.6 (VOD)
UC_GND: C1.2, C2.2, C3.2, JP23.9, JP23.10, U$1.P4_02 (GND5), U$1.P4_40 (GND6), U$1.P5_01 (GND1), U$1.P5_21 (GND2), U$1.P5_22 (GND3), U$1.P5_39 (GND4), U$2.2 (GND1), U$2.8 (GND1B), U$3.9 (GND2B), U$3.15 (GND2), U$4.2 (GND1), U$4.3 (VIA), U$4.8 (GND1B); also elsewhere on the board
UC_RESET: U$1.P4_22, U$2.6 (VID)
UC_SCLK: U$1.P4_24, U$2.4 (VIB)
UC_SDI: U$1.P4_23, U$2.3 (VIA)
UC_SDO_0: U$1.P5_35, U$3.11 (VOD)
UC_SDO_1: U$1.P5_36, U$3.12 (VOC)
UC_SDO_2: U$1.P5_37, U$3.13 (VOB)
UC_SDO_3: U$1.P5_38, U$3.14 (VOA)
UC_START: U$1.P5_26, U$4.4 (VIB)

Notes on the sheet:
UC TO ADC (SPI CONTROL)
ADC TO UC (DATA INPUT)
BIDIRECTIONAL (LEFTOVER PINS)
MIMAS A7 MINI - FPGA BOARD
BOTTOM BOARD PINS MATCH MID BOARD
SDC CONTROL PINS
AUX PINS - BLOCK 01
DIGITAL POWER CONNECTION

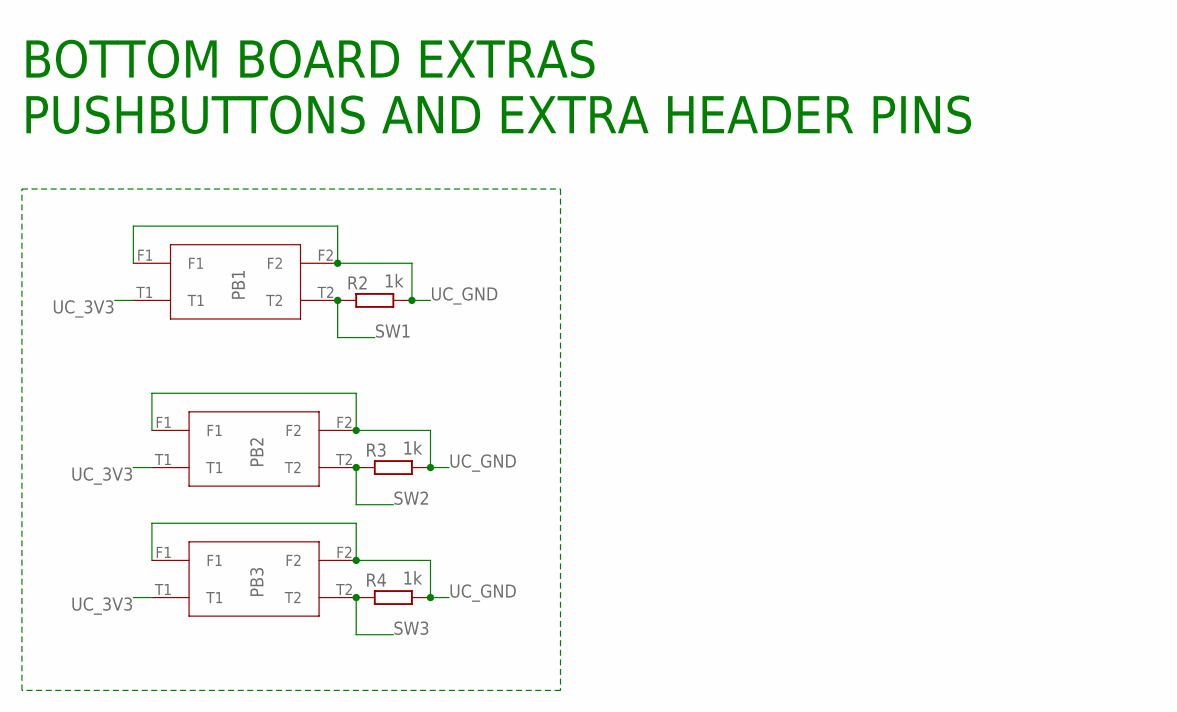
[picture p16: schematic EIT_Recorder.sch, sheet 2, TOP BOARD CONNECTOR MATCHING]

Parts:
PB1, PB2, PB3: PUSHBUTTON_95C06B2RAT
R2, R3, R4: 1k; R0805

Connections:
SW1: PB1.T2, R2.1; also elsewhere on the board
SW2: PB2.T2, R3.1; also elsewhere on the board
SW3: PB3.T2, R4.1; also elsewhere on the board
UC_3V3: PB1.T1, PB2.T1, PB3.T1; also elsewhere on the board
UC_GND: PB1.F1, PB1.F2, PB2.F1, PB2.F2, PB3.F1, PB3.F2, R2.2, R3.2, R4.2; also elsewhere on the board

Notes on the sheet:
BOTTOM BOARD EXTRAS PUSHBUTTONS AND EXTRA HEADER PINS

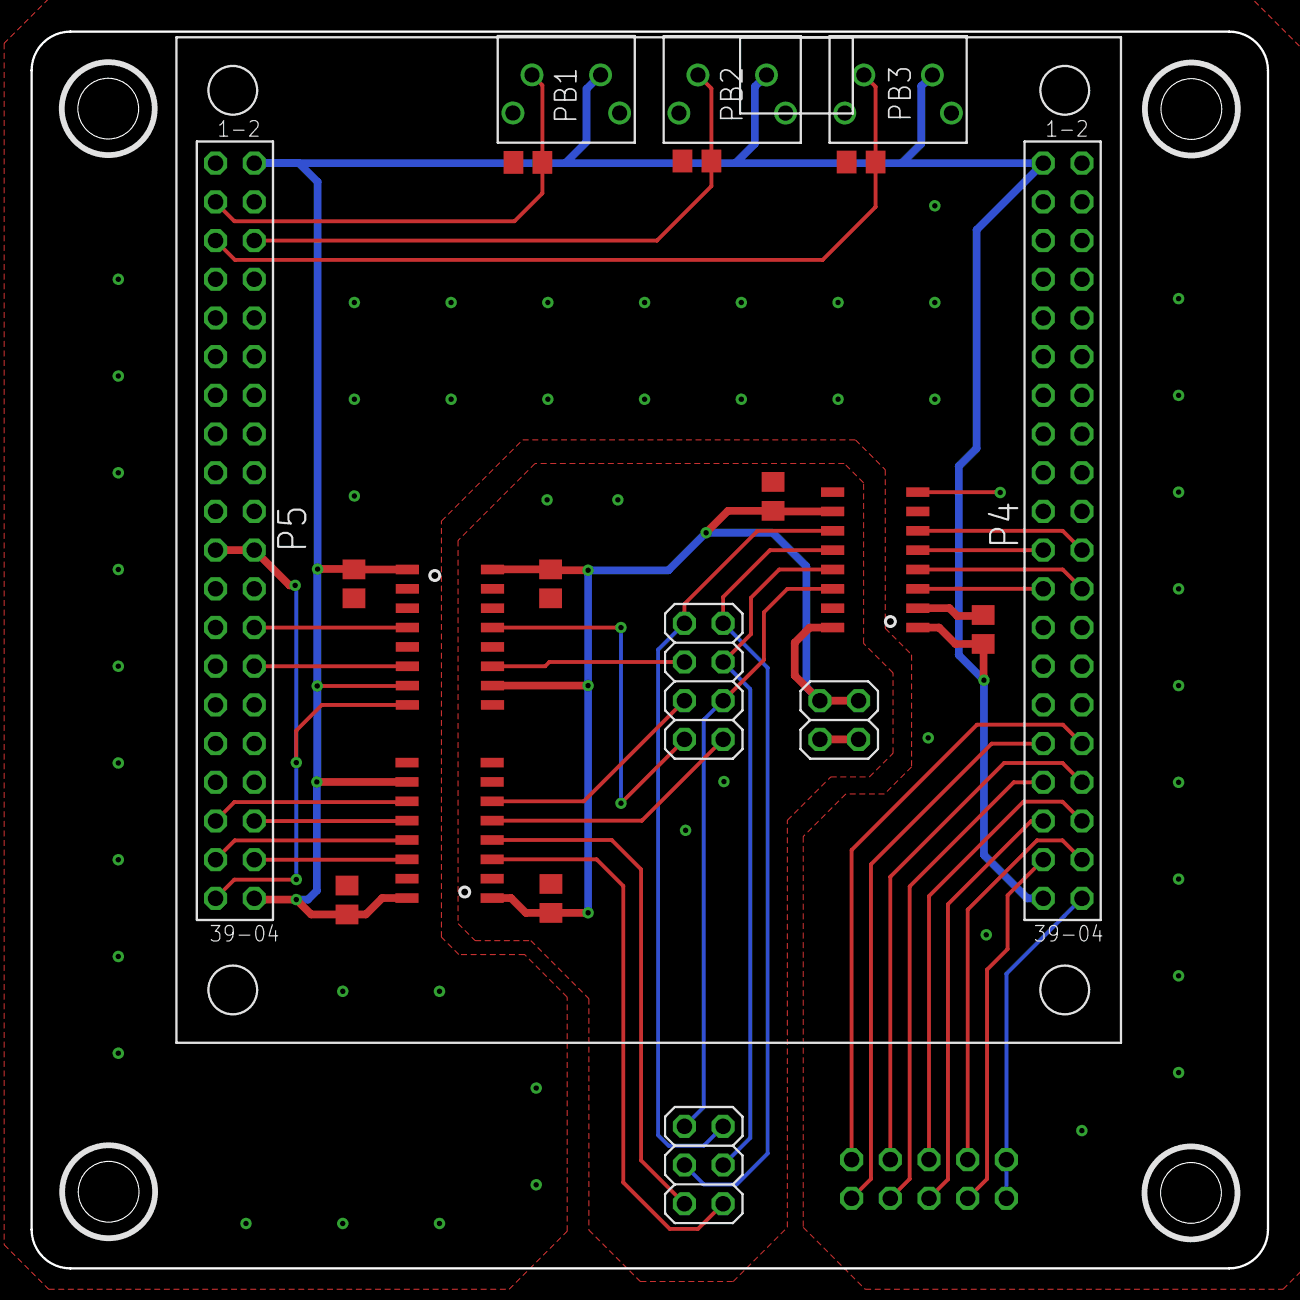
[picture p17: board Schematics/EIT_Recorder_Bottom/EIT_Recorder.brd from above]

Board: 2 copper layers, 81.2 x 81.2 mm, 20 parts (1 on the bottom side), 35 nets.
